KaiPeng21/VirtualSport/README.md

# VirtualSport
ECE477 Digital System Design Project
