KaiPeng21/VirtualSport/ECE477-SeniorDesignProject/Software/Microprocessor/MDK-ARM/Final-Version-1/Final-Version-1.htm

# Static Call Graph for image Final-Version-1\Final-Version-1.axf

#<CALLGRAPH># ARM Linker, 5060528: Last Updated: Mon Oct 30 10:10:53 2017

### Maximum Stack Usage = 152 bytes + Unknown(Cycles, Untraceable Function Pointers)

### Call chain for Maximum Stack Depth:

main ⇒ SystemClock_Config ⇒ HAL_RCC_ClockConfig ⇒ HAL_InitTick ⇒ HAL_NVIC_SetPriority

### Mutually Recursive functions

- ADC_IRQHandler ⇒ ADC_IRQHandler
- BusFault_Handler ⇒ BusFault_Handler
- HardFault_Handler ⇒ HardFault_Handler
- MemManage_Handler ⇒ MemManage_Handler
- UsageFault_Handler ⇒ UsageFault_Handler

### Function Pointers

- ADC_IRQHandler from startup_stm32f407xx.o(.text) referenced from startup_stm32f407xx.o(RESET)
- BusFault_Handler from stm32f4xx_it.o(i.BusFault_Handler) referenced from startup_stm32f407xx.o(RESET)
- CAN1_RX0_IRQHandler from startup_stm32f407xx.o(.text) referenced from startup_stm32f407xx.o(RESET)
- CAN1_RX1_IRQHandler from startup_stm32f407xx.o(.text) referenced from startup_stm32f407xx.o(RESET)
- CAN1_SCE_IRQHandler from startup_stm32f407xx.o(.text) referenced from startup_stm32f407xx.o(RESET)
- CAN1_TX_IRQHandler from startup_stm32f407xx.o(.text) referenced from startup_stm32f407xx.o(RESET)
- CAN2_RX0_IRQHandler from startup_stm32f407xx.o(.text) referenced from startup_stm32f407xx.o(RESET)
- CAN2_RX1_IRQHandler from startup_stm32f407xx.o(.text) referenced from startup_stm32f407xx.o(RESET)
- CAN2_SCE_IRQHandler from startup_stm32f407xx.o(.text) referenced from startup_stm32f407xx.o(RESET)
- CAN2_TX_IRQHandler from startup_stm32f407xx.o(.text) referenced from startup_stm32f407xx.o(RESET)
- DCMI_IRQHandler from startup_stm32f407xx.o(.text) referenced from startup_stm32f407xx.o(RESET)
- DMA1_Stream0_IRQHandler from startup_stm32f407xx.o(.text) referenced from startup_stm32f407xx.o(RESET)
- DMA1_Stream1_IRQHandler from startup_stm32f407xx.o(.text) referenced from startup_stm32f407xx.o(RESET)
- DMA1_Stream2_IRQHandler from startup_stm32f407xx.o(.text) referenced from startup_stm32f407xx.o(RESET)
- DMA1_Stream3_IRQHandler from startup_stm32f407xx.o(.text) referenced from startup_stm32f407xx.o(RESET)
- DMA1_Stream4_IRQHandler from startup_stm32f407xx.o(.text) referenced from startup_stm32f407xx.o(RESET)
- DMA1_Stream5_IRQHandler from startup_stm32f407xx.o(.text) referenced from startup_stm32f407xx.o(RESET)
- DMA1_Stream6_IRQHandler from startup_stm32f407xx.o(.text) referenced from startup_stm32f407xx.o(RESET)
- DMA1_Stream7_IRQHandler from startup_stm32f407xx.o(.text) referenced from startup_stm32f407xx.o(RESET)
- DMA2_Stream0_IRQHandler from startup_stm32f407xx.o(.text) referenced from startup_stm32f407xx.o(RESET)
- DMA2_Stream1_IRQHandler from startup_stm32f407xx.o(.text) referenced from startup_stm32f407xx.o(RESET)
- DMA2_Stream2_IRQHandler from startup_stm32f407xx.o(.text) referenced from startup_stm32f407xx.o(RESET)
- DMA2_Stream3_IRQHandler from startup_stm32f407xx.o(.text) referenced from startup_stm32f407xx.o(RESET)
- DMA2_Stream4_IRQHandler from startup_stm32f407xx.o(.text) referenced from startup_stm32f407xx.o(RESET)
- DMA2_Stream5_IRQHandler from startup_stm32f407xx.o(.text) referenced from startup_stm32f407xx.o(RESET)
- DMA2_Stream6_IRQHandler from startup_stm32f407xx.o(.text) referenced from startup_stm32f407xx.o(RESET)
- DMA2_Stream7_IRQHandler from startup_stm32f407xx.o(.text) referenced from startup_stm32f407xx.o(RESET)
- DebugMon_Handler from stm32f4xx_it.o(i.DebugMon_Handler) referenced from startup_stm32f407xx.o(RESET)
- ETH_IRQHandler from startup_stm32f407xx.o(.text) referenced from startup_stm32f407xx.o(RESET)
- ETH_WKUP_IRQHandler from startup_stm32f407xx.o(.text) referenced from startup_stm32f407xx.o(RESET)
- EXTI0_IRQHandler from startup_stm32f407xx.o(.text) referenced from startup_stm32f407xx.o(RESET)
- EXTI15_10_IRQHandler from startup_stm32f407xx.o(.text) referenced from startup_stm32f407xx.o(RESET)
- EXTI1_IRQHandler from startup_stm32f407xx.o(.text) referenced from startup_stm32f407xx.o(RESET)
- EXTI2_IRQHandler from startup_stm32f407xx.o(.text) referenced from startup_stm32f407xx.o(RESET)
- EXTI3_IRQHandler from startup_stm32f407xx.o(.text) referenced from startup_stm32f407xx.o(RESET)
- EXTI4_IRQHandler from startup_stm32f407xx.o(.text) referenced from startup_stm32f407xx.o(RESET)
- EXTI9_5_IRQHandler from startup_stm32f407xx.o(.text) referenced from startup_stm32f407xx.o(RESET)
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
- TIM7_IRQHandler from startup_stm32f407xx.o(.text) referenced from startup_stm32f407xx.o(RESET)
- TIM8_BRK_TIM12_IRQHandler from startup_stm32f407xx.o(.text) referenced from startup_stm32f407xx.o(RESET)
- TIM8_CC_IRQHandler from startup_stm32f407xx.o(.text) referenced from startup_stm32f407xx.o(RESET)
- TIM8_TRG_COM_TIM14_IRQHandler from startup_stm32f407xx.o(.text) referenced from startup_stm32f407xx.o(RESET)
- TIM8_UP_TIM13_IRQHandler from startup_stm32f407xx.o(.text) referenced from startup_stm32f407xx.o(RESET)
- UART4_IRQHandler from startup_stm32f407xx.o(.text) referenced from startup_stm32f407xx.o(RESET)
- UART5_IRQHandler from startup_stm32f407xx.o(.text) referenced from startup_stm32f407xx.o(RESET)
- UART_DMAAbortOnError from stm32f4xx_hal_uart.o(i.UART_DMAAbortOnError) referenced from stm32f4xx_hal_uart.o(i.HAL_UART_IRQHandler)
- USART1_IRQHandler from stm32f4xx_it.o(i.USART1_IRQHandler) referenced from startup_stm32f407xx.o(RESET)
- USART2_IRQHandler from startup_stm32f407xx.o(.text) referenced from startup_stm32f407xx.o(RESET)
- USART3_IRQHandler from startup_stm32f407xx.o(.text) referenced from startup_stm32f407xx.o(RESET)
- USART6_IRQHandler from startup_stm32f407xx.o(.text) referenced from startup_stm32f407xx.o(RESET)
- UsageFault_Handler from stm32f4xx_it.o(i.UsageFault_Handler) referenced from startup_stm32f407xx.o(RESET)
- WWDG_IRQHandler from startup_stm32f407xx.o(.text) referenced from startup_stm32f407xx.o(RESET)
- __main from entry.o(.ARM.Collect$$$$00000000) referenced from startup_stm32f407xx.o(.text)
- main from main.o(i.main) referenced from entry9a.o(.ARM.Collect$$$$0000000B)

### Global Symbols

__main (Thumb, 0 bytes, Stack size unknown bytes, entry.o(.ARM.Collect$$$$00000000))
[Address Reference Count : 1]

- startup_stm32f407xx.o(.text)

_main_stk (Thumb, 0 bytes, Stack size unknown bytes, entry2.o(.ARM.Collect$$$$00000001))

_main_scatterload (Thumb, 0 bytes, Stack size unknown bytes, entry5.o(.ARM.Collect$$$$00000004))

[Calls]

- >> __scatterload

__main_after_scatterload (Thumb, 0 bytes, Stack size unknown bytes, entry5.o(.ARM.Collect$$$$00000004))

[Called By]

- >> __scatterload

_main_clock (Thumb, 0 bytes, Stack size unknown bytes, entry7b.o(.ARM.Collect$$$$00000008))

_main_cpp_init (Thumb, 0 bytes, Stack size unknown bytes, entry8b.o(.ARM.Collect$$$$0000000A))

_main_init (Thumb, 0 bytes, Stack size unknown bytes, entry9a.o(.ARM.Collect$$$$0000000B))

__rt_final_cpp (Thumb, 0 bytes, Stack size unknown bytes, entry10a.o(.ARM.Collect$$$$0000000D))

__rt_final_exit (Thumb, 0 bytes, Stack size unknown bytes, entry11a.o(.ARM.Collect$$$$0000000F))

Reset_Handler (Thumb, 8 bytes, Stack size 0 bytes, startup_stm32f407xx.o(.text))
[Address Reference Count : 1]

- startup_stm32f407xx.o(RESET)

ADC_IRQHandler (Thumb, 0 bytes, Stack size 0 bytes, startup_stm32f407xx.o(.text))

[Calls]

- >> ADC_IRQHandler

[Called By]

- >> ADC_IRQHandler

[Address Reference Count : 1]

- startup_stm32f407xx.o(RESET)

CAN1_RX0_IRQHandler (Thumb, 0 bytes, Stack size 0 bytes, startup_stm32f407xx.o(.text))
[Address Reference Count : 1]

- startup_stm32f407xx.o(RESET)

CAN1_RX1_IRQHandler (Thumb, 0 bytes, Stack size 0 bytes, startup_stm32f407xx.o(.text))
[Address Reference Count : 1]

- startup_stm32f407xx.o(RESET)

CAN1_SCE_IRQHandler (Thumb, 0 bytes, Stack size 0 bytes, startup_stm32f407xx.o(.text))
[Address Reference Count : 1]

- startup_stm32f407xx.o(RESET)

CAN1_TX_IRQHandler (Thumb, 0 bytes, Stack size 0 bytes, startup_stm32f407xx.o(.text))
[Address Reference Count : 1]

- startup_stm32f407xx.o(RESET)

CAN2_RX0_IRQHandler (Thumb, 0 bytes, Stack size 0 bytes, startup_stm32f407xx.o(.text))
[Address Reference Count : 1]

- startup_stm32f407xx.o(RESET)

CAN2_RX1_IRQHandler (Thumb, 0 bytes, Stack size 0 bytes, startup_stm32f407xx.o(.text))
[Address Reference Count : 1]

- startup_stm32f407xx.o(RESET)

CAN2_SCE_IRQHandler (Thumb, 0 bytes, Stack size 0 bytes, startup_stm32f407xx.o(.text))
[Address Reference Count : 1]

- startup_stm32f407xx.o(RESET)

CAN2_TX_IRQHandler (Thumb, 0 bytes, Stack size 0 bytes, startup_stm32f407xx.o(.text))
[Address Reference Count : 1]

- startup_stm32f407xx.o(RESET)

DCMI_IRQHandler (Thumb, 0 bytes, Stack size 0 bytes, startup_stm32f407xx.o(.text))
[Address Reference Count : 1]

- startup_stm32f407xx.o(RESET)

DMA1_Stream0_IRQHandler (Thumb, 0 bytes, Stack size 0 bytes, startup_stm32f407xx.o(.text))
[Address Reference Count : 1]

- startup_stm32f407xx.o(RESET)

DMA1_Stream1_IRQHandler (Thumb, 0 bytes, Stack size 0 bytes, startup_stm32f407xx.o(.text))
[Address Reference Count : 1]

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
[Address Reference Count : 1]

- startup_stm32f407xx.o(RESET)

TIM1_BRK_TIM9_IRQHandler (Thumb, 0 bytes, Stack size 0 bytes, startup_stm32f407xx.o(.text))
[Address Reference Count : 1]

- startup_stm32f407xx.o(RESET)

TIM1_CC_IRQHandler (Thumb, 0 bytes, Stack size 0 bytes, startup_stm32f407xx.o(.text))
[Address Reference Count : 1]

- startup_stm32f407xx.o(RESET)

TIM1_TRG_COM_TIM11_IRQHandler (Thumb, 0 bytes, Stack size 0 bytes, startup_stm32f407xx.o(.text))
[Address Reference Count : 1]

- startup_stm32f407xx.o(RESET)

TIM1_UP_TIM10_IRQHandler (Thumb, 0 bytes, Stack size 0 bytes, startup_stm32f407xx.o(.text))
[Address Reference Count : 1]

- startup_stm32f407xx.o(RESET)

TIM2_IRQHandler (Thumb, 0 bytes, Stack size 0 bytes, startup_stm32f407xx.o(.text))
[Address Reference Count : 1]

- startup_stm32f407xx.o(RESET)

TIM5_IRQHandler (Thumb, 0 bytes, Stack size 0 bytes, startup_stm32f407xx.o(.text))
[Address Reference Count : 1]

- startup_stm32f407xx.o(RESET)

TIM7_IRQHandler (Thumb, 0 bytes, Stack size 0 bytes, startup_stm32f407xx.o(.text))
[Address Reference Count : 1]

- startup_stm32f407xx.o(RESET)

TIM8_BRK_TIM12_IRQHandler (Thumb, 0 bytes, Stack size 0 bytes, startup_stm32f407xx.o(.text))
[Address Reference Count : 1]

- startup_stm32f407xx.o(RESET)

TIM8_CC_IRQHandler (Thumb, 0 bytes, Stack size 0 bytes, startup_stm32f407xx.o(.text))
[Address Reference Count : 1]

- startup_stm32f407xx.o(RESET)

TIM8_TRG_COM_TIM14_IRQHandler (Thumb, 0 bytes, Stack size 0 bytes, startup_stm32f407xx.o(.text))
[Address Reference Count : 1]

- startup_stm32f407xx.o(RESET)

TIM8_UP_TIM13_IRQHandler (Thumb, 0 bytes, Stack size 0 bytes, startup_stm32f407xx.o(.text))
[Address Reference Count : 1]

- startup_stm32f407xx.o(RESET)

UART4_IRQHandler (Thumb, 0 bytes, Stack size 0 bytes, startup_stm32f407xx.o(.text))
[Address Reference Count : 1]

- startup_stm32f407xx.o(RESET)

UART5_IRQHandler (Thumb, 0 bytes, Stack size 0 bytes, startup_stm32f407xx.o(.text))
[Address Reference Count : 1]

- startup_stm32f407xx.o(RESET)

USART2_IRQHandler (Thumb, 0 bytes, Stack size 0 bytes, startup_stm32f407xx.o(.text))
[Address Reference Count : 1]

- startup_stm32f407xx.o(RESET)

USART3_IRQHandler (Thumb, 0 bytes, Stack size 0 bytes, startup_stm32f407xx.o(.text))
[Address Reference Count : 1]

- startup_stm32f407xx.o(RESET)

USART6_IRQHandler (Thumb, 0 bytes, Stack size 0 bytes, startup_stm32f407xx.o(.text))
[Address Reference Count : 1]

- startup_stm32f407xx.o(RESET)

WWDG_IRQHandler (Thumb, 0 bytes, Stack size 0 bytes, startup_stm32f407xx.o(.text))
[Address Reference Count : 1]

- startup_stm32f407xx.o(RESET)

__scatterload (Thumb, 28 bytes, Stack size 0 bytes, init.o(.text))

[Calls]

- >> __main_after_scatterload

[Called By]

- >> _main_scatterload

__scatterload_rt2 (Thumb, 0 bytes, Stack size 0 bytes, init.o(.text), UNUSED)

Bluetooth_Pack_and_Send (Thumb, 216 bytes, Stack size 16 bytes, main.o(i.Bluetooth_Pack_and_Send))

[Stack]

- Max Depth = 72
- Call Chain = Bluetooth_Pack_and_Send ⇒ HAL_UART_Transmit ⇒ UART_WaitOnFlagUntilTimeout

[Calls]

- >> HAL_UART_Transmit

[Called By]

- >> main

BusFault_Handler (Thumb, 2 bytes, Stack size 0 bytes, stm32f4xx_it.o(i.BusFault_Handler))

[Calls]

- >> BusFault_Handler

[Called By]

- >> BusFault_Handler

[Address Reference Count : 1]

- startup_stm32f407xx.o(RESET)

DRV_Go (Thumb, 36 bytes, Stack size 8 bytes, main.o(i.DRV_Go))

[Stack]

- Max Depth = 104
- Call Chain = DRV_Go ⇒ HAL_I2C_Master_Transmit ⇒ I2C_MasterRequestWrite ⇒ I2C_WaitOnMasterAddressFlagUntilTimeout

[Calls]

- >> HAL_I2C_Master_Transmit

[Called By]

- >> Haptics_VibrateMid
- >> Haptics_VibrateLow
- >> Haptics_VibrateHigh

DRV_SetWaveform (Thumb, 36 bytes, Stack size 16 bytes, main.o(i.DRV_SetWaveform))

[Stack]

- Max Depth = 112
- Call Chain = DRV_SetWaveform ⇒ HAL_I2C_Master_Transmit ⇒ I2C_MasterRequestWrite ⇒ I2C_WaitOnMasterAddressFlagUntilTimeout

[Calls]

- >> HAL_I2C_Master_Transmit

[Called By]

- >> Haptics_VibrateMid
- >> Haptics_VibrateLow
- >> Haptics_VibrateHigh

DebugMon_Handler (Thumb, 2 bytes, Stack size 0 bytes, stm32f4xx_it.o(i.DebugMon_Handler))
[Address Reference Count : 1]

- startup_stm32f407xx.o(RESET)

HAL_DMA_Abort_IT (Thumb, 36 bytes, Stack size 0 bytes, stm32f4xx_hal_dma.o(i.HAL_DMA_Abort_IT))

[Called By]

- >> HAL_UART_IRQHandler

HAL_Delay (Thumb, 28 bytes, Stack size 16 bytes, stm32f4xx_hal.o(i.HAL_Delay))

[Stack]

- Max Depth = 16
- Call Chain = HAL_Delay

[Calls]

- >> HAL_GetTick

[Called By]

- >> main

HAL_GPIO_Init (Thumb, 388 bytes, Stack size 40 bytes, stm32f4xx_hal_gpio.o(i.HAL_GPIO_Init))

[Stack]

- Max Depth = 40
- Call Chain = HAL_GPIO_Init

[Called By]

- >> HAL_UART_MspInit
- >> HAL_I2C_MspInit
- >> HAL_TIM_MspPostInit
- >> MX_GPIO_Init

HAL_GPIO_ReadPin (Thumb, 10 bytes, Stack size 0 bytes, stm32f4xx_hal_gpio.o(i.HAL_GPIO_ReadPin))

[Called By]

- >> main

HAL_GetTick (Thumb, 6 bytes, Stack size 0 bytes, stm32f4xx_hal.o(i.HAL_GetTick))

[Called By]

- >> HAL_UART_Transmit
- >> HAL_UART_Receive
- >> HAL_RCC_OscConfig
- >> HAL_RCC_ClockConfig
- >> HAL_I2C_Master_Transmit
- >> HAL_I2C_Master_Receive
- >> HAL_Delay
- >> I2C_WaitOnTXEFlagUntilTimeout
- >> I2C_WaitOnRXNEFlagUntilTimeout
- >> I2C_WaitOnMasterAddressFlagUntilTimeout
- >> I2C_WaitOnFlagUntilTimeout
- >> I2C_WaitOnBTFFlagUntilTimeout
- >> UART_WaitOnFlagUntilTimeout

HAL_I2C_Init (Thumb, 254 bytes, Stack size 16 bytes, stm32f4xx_hal_i2c.o(i.HAL_I2C_Init))

[Stack]

- Max Depth = 104
- Call Chain = HAL_I2C_Init ⇒ HAL_I2C_MspInit ⇒ HAL_GPIO_Init

[Calls]

- >> HAL_I2C_MspInit
- >> HAL_RCC_GetPCLK1Freq

[Called By]

- >> MX_I2C2_Init
- >> MX_I2C1_Init

HAL_I2C_Master_Receive (Thumb, 474 bytes, Stack size 40 bytes, stm32f4xx_hal_i2c.o(i.HAL_I2C_Master_Receive))

[Stack]

- Max Depth = 112
- Call Chain = HAL_I2C_Master_Receive ⇒ I2C_MasterRequestRead ⇒ I2C_WaitOnMasterAddressFlagUntilTimeout

[Calls]

- >> HAL_GetTick
- >> I2C_WaitOnRXNEFlagUntilTimeout
- >> I2C_WaitOnFlagUntilTimeout
- >> I2C_MasterRequestRead

[Called By]

- >> main

HAL_I2C_Master_Transmit (Thumb, 304 bytes, Stack size 40 bytes, stm32f4xx_hal_i2c.o(i.HAL_I2C_Master_Transmit))

[Stack]

- Max Depth = 96
- Call Chain = HAL_I2C_Master_Transmit ⇒ I2C_MasterRequestWrite ⇒ I2C_WaitOnMasterAddressFlagUntilTimeout

[Calls]

- >> HAL_GetTick
- >> I2C_WaitOnTXEFlagUntilTimeout
- >> I2C_WaitOnFlagUntilTimeout
- >> I2C_WaitOnBTFFlagUntilTimeout
- >> I2C_MasterRequestWrite

[Called By]

- >> main
- >> DRV_SetWaveform
- >> DRV_Go

HAL_I2C_MspInit (Thumb, 92 bytes, Stack size 48 bytes, stm32f4xx_hal_msp.o(i.HAL_I2C_MspInit))

[Stack]

- Max Depth = 88
- Call Chain = HAL_I2C_MspInit ⇒ HAL_GPIO_Init

[Calls]

- >> HAL_GPIO_Init

[Called By]

- >> HAL_I2C_Init

HAL_IncTick (Thumb, 10 bytes, Stack size 0 bytes, stm32f4xx_hal.o(i.HAL_IncTick))

[Called By]

- >> SysTick_Handler

HAL_Init (Thumb, 48 bytes, Stack size 8 bytes, stm32f4xx_hal.o(i.HAL_Init))

[Stack]

- Max Depth = 32
- Call Chain = HAL_Init ⇒ HAL_MspInit ⇒ HAL_NVIC_SetPriority

[Calls]

- >> HAL_NVIC_SetPriorityGrouping
- >> HAL_MspInit
- >> HAL_InitTick

[Called By]

- >> main

HAL_InitTick (Thumb, 34 bytes, Stack size 8 bytes, stm32f4xx_hal.o(i.HAL_InitTick))

[Stack]

- Max Depth = 24
- Call Chain = HAL_InitTick ⇒ HAL_NVIC_SetPriority

[Calls]

- >> HAL_SYSTICK_Config
- >> HAL_NVIC_SetPriority

[Called By]

- >> HAL_RCC_ClockConfig
- >> HAL_Init

HAL_MspInit (Thumb, 88 bytes, Stack size 8 bytes, stm32f4xx_hal_msp.o(i.HAL_MspInit))

[Stack]

- Max Depth = 24
- Call Chain = HAL_MspInit ⇒ HAL_NVIC_SetPriority

[Calls]

- >> HAL_NVIC_SetPriorityGrouping
- >> HAL_NVIC_SetPriority

[Called By]

- >> HAL_Init

HAL_NVIC_EnableIRQ (Thumb, 22 bytes, Stack size 0 bytes, stm32f4xx_hal_cortex.o(i.HAL_NVIC_EnableIRQ))

[Called By]

- >> HAL_UART_MspInit
- >> HAL_TIM_PWM_MspInit
- >> HAL_TIM_Base_MspInit

HAL_NVIC_SetPriority (Thumb, 60 bytes, Stack size 16 bytes, stm32f4xx_hal_cortex.o(i.HAL_NVIC_SetPriority))

[Stack]

- Max Depth = 16
- Call Chain = HAL_NVIC_SetPriority

[Calls]

- >> NVIC_SetPriority

[Called By]

- >> HAL_UART_MspInit
- >> HAL_TIM_PWM_MspInit
- >> HAL_TIM_Base_MspInit
- >> HAL_MspInit
- >> SystemClock_Config
- >> HAL_InitTick

HAL_NVIC_SetPriorityGrouping (Thumb, 26 bytes, Stack size 0 bytes, stm32f4xx_hal_cortex.o(i.HAL_NVIC_SetPriorityGrouping))

[Called By]

- >> HAL_MspInit
- >> HAL_Init

HAL_RCC_ClockConfig (Thumb, 364 bytes, Stack size 32 bytes, stm32f4xx_hal_rcc.o(i.HAL_RCC_ClockConfig))

[Stack]

- Max Depth = 56
- Call Chain = HAL_RCC_ClockConfig ⇒ HAL_InitTick ⇒ HAL_NVIC_SetPriority

[Calls]

- >> HAL_InitTick
- >> HAL_GetTick
- >> HAL_RCC_GetSysClockFreq

[Called By]

- >> SystemClock_Config

HAL_RCC_GetHCLKFreq (Thumb, 6 bytes, Stack size 0 bytes, stm32f4xx_hal_rcc.o(i.HAL_RCC_GetHCLKFreq))

[Called By]

- >> SystemClock_Config

HAL_RCC_GetPCLK1Freq (Thumb, 34 bytes, Stack size 0 bytes, stm32f4xx_hal_rcc.o(i.HAL_RCC_GetPCLK1Freq))

[Called By]

- >> HAL_I2C_Init
- >> UART_SetConfig

HAL_RCC_GetPCLK2Freq (Thumb, 34 bytes, Stack size 0 bytes, stm32f4xx_hal_rcc.o(i.HAL_RCC_GetPCLK2Freq))

[Called By]

- >> UART_SetConfig

HAL_RCC_GetSysClockFreq (Thumb, 104 bytes, Stack size 12 bytes, stm32f4xx_hal_rcc.o(i.HAL_RCC_GetSysClockFreq))

[Stack]

- Max Depth = 12
- Call Chain = HAL_RCC_GetSysClockFreq

[Called By]

- >> HAL_RCC_ClockConfig

HAL_RCC_OscConfig (Thumb, 770 bytes, Stack size 40 bytes, stm32f4xx_hal_rcc.o(i.HAL_RCC_OscConfig))

[Stack]

- Max Depth = 40
- Call Chain = HAL_RCC_OscConfig

[Calls]

- >> HAL_GetTick

[Called By]

- >> SystemClock_Config

HAL_SYSTICK_CLKSourceConfig (Thumb, 24 bytes, Stack size 0 bytes, stm32f4xx_hal_cortex.o(i.HAL_SYSTICK_CLKSourceConfig))

[Called By]

- >> SystemClock_Config

HAL_SYSTICK_Callback (Thumb, 2 bytes, Stack size 0 bytes, stm32f4xx_hal_cortex.o(i.HAL_SYSTICK_Callback))

[Called By]

- >> HAL_SYSTICK_IRQHandler

HAL_SYSTICK_Config (Thumb, 40 bytes, Stack size 8 bytes, stm32f4xx_hal_cortex.o(i.HAL_SYSTICK_Config))

[Stack]

- Max Depth = 8
- Call Chain = HAL_SYSTICK_Config

[Calls]

- >> NVIC_SetPriority

[Called By]

- >> SystemClock_Config
- >> HAL_InitTick

HAL_SYSTICK_IRQHandler (Thumb, 8 bytes, Stack size 8 bytes, stm32f4xx_hal_cortex.o(i.HAL_SYSTICK_IRQHandler))

[Stack]

- Max Depth = 8
- Call Chain = HAL_SYSTICK_IRQHandler

[Calls]

- >> HAL_SYSTICK_Callback

[Called By]

- >> SysTick_Handler

HAL_TIMEx_BreakCallback (Thumb, 2 bytes, Stack size 0 bytes, stm32f4xx_hal_tim_ex.o(i.HAL_TIMEx_BreakCallback))

[Called By]

- >> HAL_TIM_IRQHandler

HAL_TIMEx_CommutationCallback (Thumb, 2 bytes, Stack size 0 bytes, stm32f4xx_hal_tim_ex.o(i.HAL_TIMEx_CommutationCallback))

[Called By]

- >> HAL_TIM_IRQHandler

HAL_TIMEx_MasterConfigSynchronization (Thumb, 80 bytes, Stack size 12 bytes, stm32f4xx_hal_tim_ex.o(i.HAL_TIMEx_MasterConfigSynchronization))

[Stack]

- Max Depth = 12
- Call Chain = HAL_TIMEx_MasterConfigSynchronization

[Called By]

- >> main
- >> MX_TIM4_Init
- >> MX_TIM3_Init

HAL_TIM_Base_Init (Thumb, 54 bytes, Stack size 8 bytes, stm32f4xx_hal_tim.o(i.HAL_TIM_Base_Init))

[Stack]

- Max Depth = 32
- Call Chain = HAL_TIM_Base_Init ⇒ HAL_TIM_Base_MspInit ⇒ HAL_NVIC_SetPriority

[Calls]

- >> HAL_TIM_Base_MspInit
- >> TIM_Base_SetConfig

[Called By]

- >> main

HAL_TIM_Base_MspInit (Thumb, 50 bytes, Stack size 8 bytes, stm32f4xx_hal_msp.o(i.HAL_TIM_Base_MspInit))

[Stack]

- Max Depth = 24
- Call Chain = HAL_TIM_Base_MspInit ⇒ HAL_NVIC_SetPriority

[Calls]

- >> HAL_NVIC_EnableIRQ
- >> HAL_NVIC_SetPriority

[Called By]

- >> HAL_TIM_Base_Init

HAL_TIM_Base_Start_IT (Thumb, 24 bytes, Stack size 0 bytes, stm32f4xx_hal_tim.o(i.HAL_TIM_Base_Start_IT))

[Called By]

- >> main

HAL_TIM_IC_CaptureCallback (Thumb, 2 bytes, Stack size 0 bytes, stm32f4xx_hal_tim.o(i.HAL_TIM_IC_CaptureCallback))

[Called By]

- >> HAL_TIM_IRQHandler

HAL_TIM_IRQHandler (Thumb, 358 bytes, Stack size 16 bytes, stm32f4xx_hal_tim.o(i.HAL_TIM_IRQHandler))

[Stack]

- Max Depth = 16
- Call Chain = HAL_TIM_IRQHandler

[Calls]

- >> HAL_TIM_PeriodElapsedCallback
- >> HAL_TIM_TriggerCallback
- >> HAL_TIM_PWM_PulseFinishedCallback
- >> HAL_TIM_OC_DelayElapsedCallback
- >> HAL_TIM_IC_CaptureCallback
- >> HAL_TIMEx_CommutationCallback
- >> HAL_TIMEx_BreakCallback

[Called By]

- >> TIM6_DAC_IRQHandler
- >> TIM4_IRQHandler
- >> TIM3_IRQHandler

HAL_TIM_MspPostInit (Thumb, 68 bytes, Stack size 24 bytes, stm32f4xx_hal_msp.o(i.HAL_TIM_MspPostInit))

[Stack]

- Max Depth = 64
- Call Chain = HAL_TIM_MspPostInit ⇒ HAL_GPIO_Init

[Calls]

- >> HAL_GPIO_Init

[Called By]

- >> MX_TIM4_Init
- >> MX_TIM3_Init

HAL_TIM_OC_DelayElapsedCallback (Thumb, 2 bytes, Stack size 0 bytes, stm32f4xx_hal_tim.o(i.HAL_TIM_OC_DelayElapsedCallback))

[Called By]

- >> HAL_TIM_IRQHandler

HAL_TIM_PWM_ConfigChannel (Thumb, 208 bytes, Stack size 16 bytes, stm32f4xx_hal_tim.o(i.HAL_TIM_PWM_ConfigChannel))

[Stack]

- Max Depth = 28
- Call Chain = HAL_TIM_PWM_ConfigChannel ⇒ TIM_OC4_SetConfig

[Calls]

- >> TIM_OC4_SetConfig
- >> TIM_OC3_SetConfig
- >> TIM_OC1_SetConfig
- >> TIM_OC2_SetConfig

[Called By]

- >> MX_TIM4_Init
- >> MX_TIM3_Init

HAL_TIM_PWM_Init (Thumb, 54 bytes, Stack size 8 bytes, stm32f4xx_hal_tim.o(i.HAL_TIM_PWM_Init))

[Stack]

- Max Depth = 32
- Call Chain = HAL_TIM_PWM_Init ⇒ HAL_TIM_PWM_MspInit ⇒ HAL_NVIC_SetPriority

[Calls]

- >> HAL_TIM_PWM_MspInit
- >> TIM_Base_SetConfig

[Called By]

- >> MX_TIM4_Init
- >> MX_TIM3_Init

HAL_TIM_PWM_MspInit (Thumb, 86 bytes, Stack size 8 bytes, stm32f4xx_hal_msp.o(i.HAL_TIM_PWM_MspInit))

[Stack]

- Max Depth = 24
- Call Chain = HAL_TIM_PWM_MspInit ⇒ HAL_NVIC_SetPriority

[Calls]

- >> HAL_NVIC_EnableIRQ
- >> HAL_NVIC_SetPriority

[Called By]

- >> HAL_TIM_PWM_Init

HAL_TIM_PWM_PulseFinishedCallback (Thumb, 2 bytes, Stack size 0 bytes, stm32f4xx_hal_tim.o(i.HAL_TIM_PWM_PulseFinishedCallback))

[Called By]

- >> HAL_TIM_IRQHandler

HAL_TIM_PWM_Start (Thumb, 48 bytes, Stack size 8 bytes, stm32f4xx_hal_tim.o(i.HAL_TIM_PWM_Start))

[Stack]

- Max Depth = 16
- Call Chain = HAL_TIM_PWM_Start ⇒ TIM_CCxChannelCmd

[Calls]

- >> TIM_CCxChannelCmd

[Called By]

- >> main

HAL_TIM_PeriodElapsedCallback (Thumb, 64 bytes, Stack size 0 bytes, main.o(i.HAL_TIM_PeriodElapsedCallback))

[Called By]

- >> HAL_TIM_IRQHandler

HAL_TIM_TriggerCallback (Thumb, 2 bytes, Stack size 0 bytes, stm32f4xx_hal_tim.o(i.HAL_TIM_TriggerCallback))

[Called By]

- >> HAL_TIM_IRQHandler

HAL_UART_ErrorCallback (Thumb, 2 bytes, Stack size 0 bytes, stm32f4xx_hal_uart.o(i.HAL_UART_ErrorCallback))

[Called By]

- >> HAL_UART_IRQHandler
- >> UART_DMAAbortOnError

HAL_UART_IRQHandler (Thumb, 266 bytes, Stack size 16 bytes, stm32f4xx_hal_uart.o(i.HAL_UART_IRQHandler))

[Stack]

- Max Depth = 24
- Call Chain = HAL_UART_IRQHandler ⇒ UART_Receive_IT

[Calls]

- >> HAL_DMA_Abort_IT
- >> HAL_UART_TxCpltCallback
- >> HAL_UART_ErrorCallback
- >> UART_Transmit_IT
- >> UART_Receive_IT
- >> UART_EndRxTransfer

[Called By]

- >> USART1_IRQHandler

HAL_UART_Init (Thumb, 98 bytes, Stack size 16 bytes, stm32f4xx_hal_uart.o(i.HAL_UART_Init))

[Stack]

- Max Depth = 96
- Call Chain = HAL_UART_Init ⇒ HAL_UART_MspInit ⇒ HAL_GPIO_Init

[Calls]

- >> HAL_UART_MspInit
- >> UART_SetConfig

[Called By]

- >> main

HAL_UART_MspInit (Thumb, 114 bytes, Stack size 40 bytes, stm32f4xx_hal_msp.o(i.HAL_UART_MspInit))

[Stack]

- Max Depth = 80
- Call Chain = HAL_UART_MspInit ⇒ HAL_GPIO_Init

[Calls]

- >> HAL_NVIC_EnableIRQ
- >> HAL_NVIC_SetPriority
- >> HAL_GPIO_Init

[Called By]

- >> HAL_UART_Init

HAL_UART_Receive (Thumb, 184 bytes, Stack size 32 bytes, stm32f4xx_hal_uart.o(i.HAL_UART_Receive))

[Stack]

- Max Depth = 56
- Call Chain = HAL_UART_Receive ⇒ UART_WaitOnFlagUntilTimeout

[Calls]

- >> HAL_GetTick
- >> UART_WaitOnFlagUntilTimeout

[Called By]

- >> main

HAL_UART_RxCpltCallback (Thumb, 2 bytes, Stack size 0 bytes, stm32f4xx_hal_uart.o(i.HAL_UART_RxCpltCallback))

[Called By]

- >> UART_Receive_IT

HAL_UART_Transmit (Thumb, 186 bytes, Stack size 32 bytes, stm32f4xx_hal_uart.o(i.HAL_UART_Transmit))

[Stack]

- Max Depth = 56
- Call Chain = HAL_UART_Transmit ⇒ UART_WaitOnFlagUntilTimeout

[Calls]

- >> HAL_GetTick
- >> UART_WaitOnFlagUntilTimeout

[Called By]

- >> Bluetooth_Pack_and_Send

HAL_UART_TxCpltCallback (Thumb, 2 bytes, Stack size 0 bytes, stm32f4xx_hal_uart.o(i.HAL_UART_TxCpltCallback))

[Called By]

- >> HAL_UART_IRQHandler

Haptics_VibrateHigh (Thumb, 66 bytes, Stack size 8 bytes, main.o(i.Haptics_VibrateHigh))

[Stack]

- Max Depth = 120
- Call Chain = Haptics_VibrateHigh ⇒ DRV_SetWaveform ⇒ HAL_I2C_Master_Transmit ⇒ I2C_MasterRequestWrite ⇒ I2C_WaitOnMasterAddressFlagUntilTimeout

[Calls]

- >> DRV_SetWaveform
- >> DRV_Go

[Called By]

- >> main

Haptics_VibrateLow (Thumb, 68 bytes, Stack size 8 bytes, main.o(i.Haptics_VibrateLow))

[Stack]

- Max Depth = 120
- Call Chain = Haptics_VibrateLow ⇒ DRV_SetWaveform ⇒ HAL_I2C_Master_Transmit ⇒ I2C_MasterRequestWrite ⇒ I2C_WaitOnMasterAddressFlagUntilTimeout

[Calls]

- >> DRV_SetWaveform
- >> DRV_Go

[Called By]

- >> main

Haptics_VibrateMid (Thumb, 66 bytes, Stack size 8 bytes, main.o(i.Haptics_VibrateMid))

[Stack]

- Max Depth = 120
- Call Chain = Haptics_VibrateMid ⇒ DRV_SetWaveform ⇒ HAL_I2C_Master_Transmit ⇒ I2C_MasterRequestWrite ⇒ I2C_WaitOnMasterAddressFlagUntilTimeout

[Calls]

- >> DRV_SetWaveform
- >> DRV_Go

[Called By]

- >> main

HardFault_Handler (Thumb, 2 bytes, Stack size 0 bytes, stm32f4xx_it.o(i.HardFault_Handler))

[Calls]

- >> HardFault_Handler

[Called By]

- >> HardFault_Handler

[Address Reference Count : 1]

- startup_stm32f407xx.o(RESET)

MemManage_Handler (Thumb, 2 bytes, Stack size 0 bytes, stm32f4xx_it.o(i.MemManage_Handler))

[Calls]

- >> MemManage_Handler

[Called By]

- >> MemManage_Handler

[Address Reference Count : 1]

- startup_stm32f407xx.o(RESET)

NMI_Handler (Thumb, 2 bytes, Stack size 0 bytes, stm32f4xx_it.o(i.NMI_Handler))
[Address Reference Count : 1]

- startup_stm32f407xx.o(RESET)

PendSV_Handler (Thumb, 2 bytes, Stack size 0 bytes, stm32f4xx_it.o(i.PendSV_Handler))
[Address Reference Count : 1]

- startup_stm32f407xx.o(RESET)

SVC_Handler (Thumb, 2 bytes, Stack size 0 bytes, stm32f4xx_it.o(i.SVC_Handler))
[Address Reference Count : 1]

- startup_stm32f407xx.o(RESET)

ServoDown (Thumb, 14 bytes, Stack size 0 bytes, main.o(i.ServoDown))

[Called By]

- >> main

ServoUp (Thumb, 14 bytes, Stack size 0 bytes, main.o(i.ServoUp))

[Called By]

- >> main

SysTick_Handler (Thumb, 14 bytes, Stack size 8 bytes, stm32f4xx_it.o(i.SysTick_Handler))

[Stack]

- Max Depth = 16
- Call Chain = SysTick_Handler ⇒ HAL_SYSTICK_IRQHandler

[Calls]

- >> HAL_SYSTICK_IRQHandler
- >> HAL_IncTick

[Address Reference Count : 1]

- startup_stm32f407xx.o(RESET)

SystemClock_Config (Thumb, 126 bytes, Stack size 80 bytes, main.o(i.SystemClock_Config))

[Stack]

- Max Depth = 136
- Call Chain = SystemClock_Config ⇒ HAL_RCC_ClockConfig ⇒ HAL_InitTick ⇒ HAL_NVIC_SetPriority

[Calls]

- >> HAL_SYSTICK_Config
- >> HAL_SYSTICK_CLKSourceConfig
- >> HAL_RCC_OscConfig
- >> HAL_RCC_GetHCLKFreq
- >> HAL_RCC_ClockConfig
- >> HAL_NVIC_SetPriority

[Called By]

- >> main

SystemInit (Thumb, 66 bytes, Stack size 0 bytes, system_stm32f4xx.o(i.SystemInit))
[Address Reference Count : 1]

- startup_stm32f407xx.o(.text)

TIM3_IRQHandler (Thumb, 6 bytes, Stack size 0 bytes, stm32f4xx_it.o(i.TIM3_IRQHandler))

[Stack]

- Max Depth = 16
- Call Chain = TIM3_IRQHandler ⇒ HAL_TIM_IRQHandler

[Calls]

- >> HAL_TIM_IRQHandler

[Address Reference Count : 1]

- startup_stm32f407xx.o(RESET)

TIM4_IRQHandler (Thumb, 6 bytes, Stack size 0 bytes, stm32f4xx_it.o(i.TIM4_IRQHandler))

[Stack]

- Max Depth = 16
- Call Chain = TIM4_IRQHandler ⇒ HAL_TIM_IRQHandler

[Calls]

- >> HAL_TIM_IRQHandler

[Address Reference Count : 1]

- startup_stm32f407xx.o(RESET)

TIM6_DAC_IRQHandler (Thumb, 6 bytes, Stack size 0 bytes, stm32f4xx_it.o(i.TIM6_DAC_IRQHandler))

[Stack]

- Max Depth = 16
- Call Chain = TIM6_DAC_IRQHandler ⇒ HAL_TIM_IRQHandler

[Calls]

- >> HAL_TIM_IRQHandler

[Address Reference Count : 1]

- startup_stm32f407xx.o(RESET)

TIM_Base_SetConfig (Thumb, 148 bytes, Stack size 20 bytes, stm32f4xx_hal_tim.o(i.TIM_Base_SetConfig))

[Stack]

- Max Depth = 20
- Call Chain = TIM_Base_SetConfig

[Called By]

- >> HAL_TIM_PWM_Init
- >> HAL_TIM_Base_Init

TIM_CCxChannelCmd (Thumb, 22 bytes, Stack size 8 bytes, stm32f4xx_hal_tim.o(i.TIM_CCxChannelCmd))

[Stack]

- Max Depth = 8
- Call Chain = TIM_CCxChannelCmd

[Called By]

- >> HAL_TIM_PWM_Start

TIM_OC2_SetConfig (Thumb, 90 bytes, Stack size 12 bytes, stm32f4xx_hal_tim.o(i.TIM_OC2_SetConfig))

[Stack]

- Max Depth = 12
- Call Chain = TIM_OC2_SetConfig

[Called By]

- >> HAL_TIM_PWM_ConfigChannel

USART1_IRQHandler (Thumb, 6 bytes, Stack size 0 bytes, stm32f4xx_it.o(i.USART1_IRQHandler))

[Stack]

- Max Depth = 24
- Call Chain = USART1_IRQHandler ⇒ HAL_UART_IRQHandler ⇒ UART_Receive_IT

[Calls]

- >> HAL_UART_IRQHandler

[Address Reference Count : 1]

- startup_stm32f407xx.o(RESET)

UsageFault_Handler (Thumb, 2 bytes, Stack size 0 bytes, stm32f4xx_it.o(i.UsageFault_Handler))

[Calls]

- >> UsageFault_Handler

[Called By]

- >> UsageFault_Handler

[Address Reference Count : 1]

- startup_stm32f407xx.o(RESET)

__scatterload_copy (Thumb, 14 bytes, Stack size unknown bytes, handlers.o(i.__scatterload_copy), UNUSED)

__scatterload_null (Thumb, 2 bytes, Stack size unknown bytes, handlers.o(i.__scatterload_null), UNUSED)

__scatterload_zeroinit (Thumb, 14 bytes, Stack size unknown bytes, handlers.o(i.__scatterload_zeroinit), UNUSED)

main (Thumb, 716 bytes, Stack size 16 bytes, main.o(i.main))

[Stack]

- Max Depth = 152
- Call Chain = main ⇒ SystemClock_Config ⇒ HAL_RCC_ClockConfig ⇒ HAL_InitTick ⇒ HAL_NVIC_SetPriority

[Calls]

- >> HAL_UART_Receive
- >> HAL_UART_Init
- >> HAL_TIM_PWM_Start
- >> HAL_TIM_Base_Start_IT
- >> HAL_TIM_Base_Init
- >> HAL_TIMEx_MasterConfigSynchronization
- >> HAL_Init
- >> HAL_I2C_Master_Transmit
- >> HAL_I2C_Master_Receive
- >> HAL_GPIO_ReadPin
- >> HAL_Delay
- >> SystemClock_Config
- >> ServoUp
- >> ServoDown
- >> Haptics_VibrateMid
- >> Haptics_VibrateLow
- >> Haptics_VibrateHigh
- >> Bluetooth_Pack_and_Send
- >> MX_TIM4_Init
- >> MX_TIM3_Init
- >> MX_I2C2_Init
- >> MX_I2C1_Init
- >> MX_GPIO_Init

[Address Reference Count : 1]

- entry9a.o(.ARM.Collect$$$$0000000B)

### Local Symbols

MX_GPIO_Init (Thumb, 108 bytes, Stack size 32 bytes, main.o(i.MX_GPIO_Init))

[Stack]

- Max Depth = 72
- Call Chain = MX_GPIO_Init ⇒ HAL_GPIO_Init

[Calls]

- >> HAL_GPIO_Init

[Called By]

- >> main

MX_I2C1_Init (Thumb, 44 bytes, Stack size 8 bytes, main.o(i.MX_I2C1_Init))

[Stack]

- Max Depth = 112
- Call Chain = MX_I2C1_Init ⇒ HAL_I2C_Init ⇒ HAL_I2C_MspInit ⇒ HAL_GPIO_Init

[Calls]

- >> HAL_I2C_Init

[Called By]

- >> main

MX_I2C2_Init (Thumb, 44 bytes, Stack size 8 bytes, main.o(i.MX_I2C2_Init))

[Stack]

- Max Depth = 112
- Call Chain = MX_I2C2_Init ⇒ HAL_I2C_Init ⇒ HAL_I2C_MspInit ⇒ HAL_GPIO_Init

[Calls]

- >> HAL_I2C_Init

[Called By]

- >> main

MX_TIM3_Init (Thumb, 128 bytes, Stack size 48 bytes, main.o(i.MX_TIM3_Init))

[Stack]

- Max Depth = 112
- Call Chain = MX_TIM3_Init ⇒ HAL_TIM_MspPostInit ⇒ HAL_GPIO_Init

[Calls]

- >> HAL_TIM_PWM_Init
- >> HAL_TIM_PWM_ConfigChannel
- >> HAL_TIM_MspPostInit
- >> HAL_TIMEx_MasterConfigSynchronization

[Called By]

- >> main

MX_TIM4_Init (Thumb, 128 bytes, Stack size 48 bytes, main.o(i.MX_TIM4_Init))

[Stack]

- Max Depth = 112
- Call Chain = MX_TIM4_Init ⇒ HAL_TIM_MspPostInit ⇒ HAL_GPIO_Init

[Calls]

- >> HAL_TIM_PWM_Init
- >> HAL_TIM_PWM_ConfigChannel
- >> HAL_TIM_MspPostInit
- >> HAL_TIMEx_MasterConfigSynchronization

[Called By]

- >> main

NVIC_SetPriority (Thumb, 32 bytes, Stack size 0 bytes, stm32f4xx_hal_cortex.o(i.NVIC_SetPriority))

[Called By]

- >> HAL_SYSTICK_Config
- >> HAL_NVIC_SetPriority

TIM_OC1_SetConfig (Thumb, 80 bytes, Stack size 12 bytes, stm32f4xx_hal_tim.o(i.TIM_OC1_SetConfig))

[Stack]

- Max Depth = 12
- Call Chain = TIM_OC1_SetConfig

[Called By]

- >> HAL_TIM_PWM_ConfigChannel

TIM_OC3_SetConfig (Thumb, 88 bytes, Stack size 12 bytes, stm32f4xx_hal_tim.o(i.TIM_OC3_SetConfig))

[Stack]

- Max Depth = 12
- Call Chain = TIM_OC3_SetConfig

[Called By]

- >> HAL_TIM_PWM_ConfigChannel

TIM_OC4_SetConfig (Thumb, 70 bytes, Stack size 12 bytes, stm32f4xx_hal_tim.o(i.TIM_OC4_SetConfig))

[Stack]

- Max Depth = 12
- Call Chain = TIM_OC4_SetConfig

[Called By]

- >> HAL_TIM_PWM_ConfigChannel

UART_DMAAbortOnError (Thumb, 16 bytes, Stack size 8 bytes, stm32f4xx_hal_uart.o(i.UART_DMAAbortOnError))

[Stack]

- Max Depth = 8
- Call Chain = UART_DMAAbortOnError

[Calls]

- >> HAL_UART_ErrorCallback

[Address Reference Count : 1]

- stm32f4xx_hal_uart.o(i.HAL_UART_IRQHandler)

UART_EndRxTransfer (Thumb, 28 bytes, Stack size 0 bytes, stm32f4xx_hal_uart.o(i.UART_EndRxTransfer))

[Called By]

- >> HAL_UART_IRQHandler

UART_Receive_IT (Thumb, 140 bytes, Stack size 8 bytes, stm32f4xx_hal_uart.o(i.UART_Receive_IT))

[Stack]

- Max Depth = 8
- Call Chain = UART_Receive_IT

[Calls]

- >> HAL_UART_RxCpltCallback

[Called By]

- >> HAL_UART_IRQHandler

UART_SetConfig (Thumb, 676 bytes, Stack size 24 bytes, stm32f4xx_hal_uart.o(i.UART_SetConfig))

[Stack]

- Max Depth = 24
- Call Chain = UART_SetConfig

[Calls]

- >> HAL_RCC_GetPCLK2Freq
- >> HAL_RCC_GetPCLK1Freq

[Called By]

- >> HAL_UART_Init

UART_Transmit_IT (Thumb, 98 bytes, Stack size 0 bytes, stm32f4xx_hal_uart.o(i.UART_Transmit_IT))

[Called By]

- >> HAL_UART_IRQHandler

UART_WaitOnFlagUntilTimeout (Thumb, 100 bytes, Stack size 24 bytes, stm32f4xx_hal_uart.o(i.UART_WaitOnFlagUntilTimeout))

[Stack]

- Max Depth = 24
- Call Chain = UART_WaitOnFlagUntilTimeout

[Calls]

- >> HAL_GetTick

[Called By]

- >> HAL_UART_Transmit
- >> HAL_UART_Receive

I2C_IsAcknowledgeFailed (Thumb, 40 bytes, Stack size 0 bytes, stm32f4xx_hal_i2c.o(i.I2C_IsAcknowledgeFailed))

[Called By]

- >> I2C_WaitOnTXEFlagUntilTimeout
- >> I2C_WaitOnBTFFlagUntilTimeout

I2C_MasterRequestRead (Thumb, 222 bytes, Stack size 40 bytes, stm32f4xx_hal_i2c.o(i.I2C_MasterRequestRead))

[Stack]

- Max Depth = 72
- Call Chain = I2C_MasterRequestRead ⇒ I2C_WaitOnMasterAddressFlagUntilTimeout

[Calls]

- >> I2C_WaitOnMasterAddressFlagUntilTimeout
- >> I2C_WaitOnFlagUntilTimeout

[Called By]

- >> HAL_I2C_Master_Receive

I2C_MasterRequestWrite (Thumb, 142 bytes, Stack size 24 bytes, stm32f4xx_hal_i2c.o(i.I2C_MasterRequestWrite))

[Stack]

- Max Depth = 56
- Call Chain = I2C_MasterRequestWrite ⇒ I2C_WaitOnMasterAddressFlagUntilTimeout

[Calls]

- >> I2C_WaitOnMasterAddressFlagUntilTimeout
- >> I2C_WaitOnFlagUntilTimeout

[Called By]

- >> HAL_I2C_Master_Transmit

I2C_WaitOnBTFFlagUntilTimeout (Thumb, 78 bytes, Stack size 16 bytes, stm32f4xx_hal_i2c.o(i.I2C_WaitOnBTFFlagUntilTimeout))

[Stack]

- Max Depth = 16
- Call Chain = I2C_WaitOnBTFFlagUntilTimeout

[Calls]

- >> HAL_GetTick
- >> I2C_IsAcknowledgeFailed

[Called By]

- >> HAL_I2C_Master_Transmit

I2C_WaitOnFlagUntilTimeout (Thumb, 96 bytes, Stack size 32 bytes, stm32f4xx_hal_i2c.o(i.I2C_WaitOnFlagUntilTimeout))

[Stack]

- Max Depth = 32
- Call Chain = I2C_WaitOnFlagUntilTimeout

[Calls]

- >> HAL_GetTick

[Called By]

- >> HAL_I2C_Master_Transmit
- >> HAL_I2C_Master_Receive
- >> I2C_MasterRequestWrite
- >> I2C_MasterRequestRead

I2C_WaitOnMasterAddressFlagUntilTimeout (Thumb, 136 bytes, Stack size 32 bytes, stm32f4xx_hal_i2c.o(i.I2C_WaitOnMasterAddressFlagUntilTimeout))

[Stack]

- Max Depth = 32
- Call Chain = I2C_WaitOnMasterAddressFlagUntilTimeout

[Calls]

- >> HAL_GetTick

[Called By]

- >> I2C_MasterRequestWrite
- >> I2C_MasterRequestRead

I2C_WaitOnRXNEFlagUntilTimeout (Thumb, 98 bytes, Stack size 24 bytes, stm32f4xx_hal_i2c.o(i.I2C_WaitOnRXNEFlagUntilTimeout))

[Stack]

- Max Depth = 24
- Call Chain = I2C_WaitOnRXNEFlagUntilTimeout

[Calls]

- >> HAL_GetTick

[Called By]

- >> HAL_I2C_Master_Receive

I2C_WaitOnTXEFlagUntilTimeout (Thumb, 78 bytes, Stack size 16 bytes, stm32f4xx_hal_i2c.o(i.I2C_WaitOnTXEFlagUntilTimeout))

[Stack]

- Max Depth = 16
- Call Chain = I2C_WaitOnTXEFlagUntilTimeout

[Calls]

- >> HAL_GetTick
- >> I2C_IsAcknowledgeFailed

[Called By]

- >> HAL_I2C_Master_Transmit

### Undefined Global Symbols
