KaiPeng21/VirtualSport/ECE477-SeniorDesignProject/Document/team03-05-BillOfMaterial.xlsx

ECE477 Bill of Materials v1.0
Year: | 2017 | Semester: | Fall |  | Project Name: | Virtual Sport
Author: |  | Chia-Hua Peng | Lingke Yu | Hengyi Lin | Yutao Hu
Created: |  | 2017-09-10
Last Modified: |  | 2017-09-15
Project_Component |  |  |  |  |  |  |  | Qty:
Description | ID | Qty | Value | Package | Manufacturer | Mfg. Part # | Supplier | Supplier Part #
STM32 Microcontroller |  | 6 | NA | 100LQFP | STMicroelectronics | STM32F407VG | Digikey | 497-11605-ND
ADXL Accelerometer |  | 3 | NA | 14-terminal LGA | AnalogDevices | ADXL345 | Digikey | ADXL345TCCZ-EP-RL-ND
MPU Accelerometer + Gyro (Backup Plan) |  | 3 | NA | QFN | TDK invenSense | MPU6050 | Digikey | 1428-1007-2-ND
DRV Haptic Driver |  | 3 | NA | 10-pin VSSOP | Texas Instruments | DRV2605L | Digikey | 296-38481-2-ND
Bluetooth LE |  | 5 | NA | Standalone | JNHuaMao | HM10 | Amazon | NA
Vibration Motor |  | 10 | NA | Standalone | Jinlong Machinery and Electronics | Z3OC1T8219731 | Amazon | NA
Servo Motor (Backup Plan) |  | 5 | NA | Standalone | TowerPro | SG90 | Amazon | NA
Linear Servo Motor |  | 2 | NA | Standalone | Dong Yang Model Technology | GS-1502 | Amazon | NA
Resistor |  | 10 | 10KOhm | 0805 | TE Connectivity AMP Connectors | RES KIT 0805RS | Digikey | RES KIT 0805RS-ND
Capacitor |  | 10 | 0.1uF | 0805 | TE Connectivity AMP Connectors | S-0805DIGI | Digikey | 709-1111-ND
DC to DC Voltage Regulator |  | 3 | 7-36V to 5V, 90.5% efficiency | 3-SIP | Murata Power Solutions Inc. | OKI-78SR-5/1.5-W36H-C | Digikey | 811-2692-ND
Current LDO Regulator |  | 10 | Max 16 Vin to 3.3 Vout | TO-236-3, SC-59, SOT-23-3 | Microchip Technology | MCP1703T-3302E/CB | Digikey | MCP1703T-3302E/CBTR-ND
