KaiPeng21/VirtualSport/ECE477-SeniorDesignProject/Mechanical/package-grp1.stl

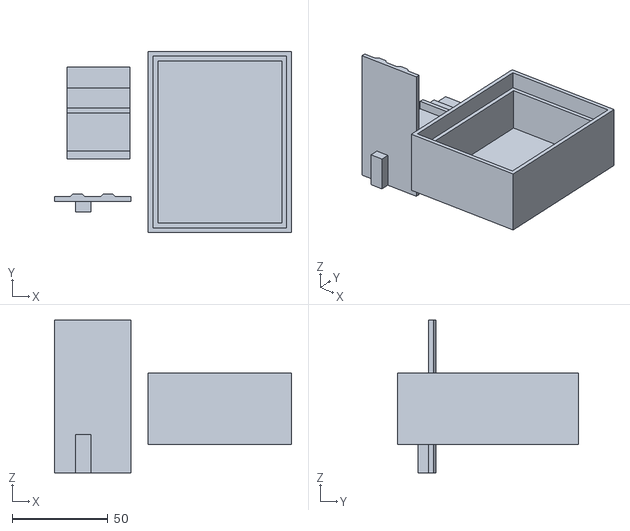
[picture p39: CAD file, 2017-12-07]
ECE477-SeniorDesignProject/Mechanical/package-grp1.stl
124.1 x 95.0 x 80.0
