KaiPeng21/VirtualSport/ECE477-SeniorDesignProject/Mechanical/package-grp3.stl

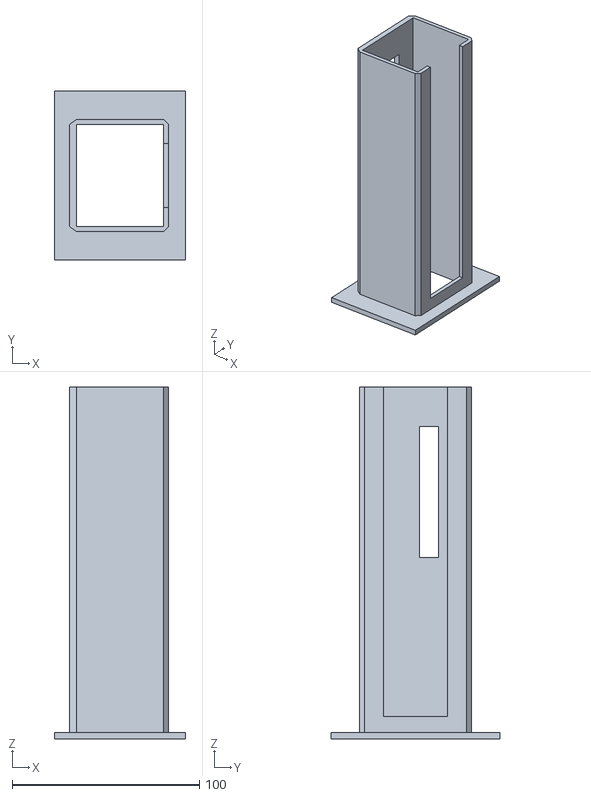
[picture p40: CAD file, 2017-12-07]
ECE477-SeniorDesignProject/Mechanical/package-grp3.stl
70.0 x 90.0 x 188.0
