KaiPeng21/VirtualSport/ECE477-SeniorDesignProject/Mechanical/linear-servo.stl

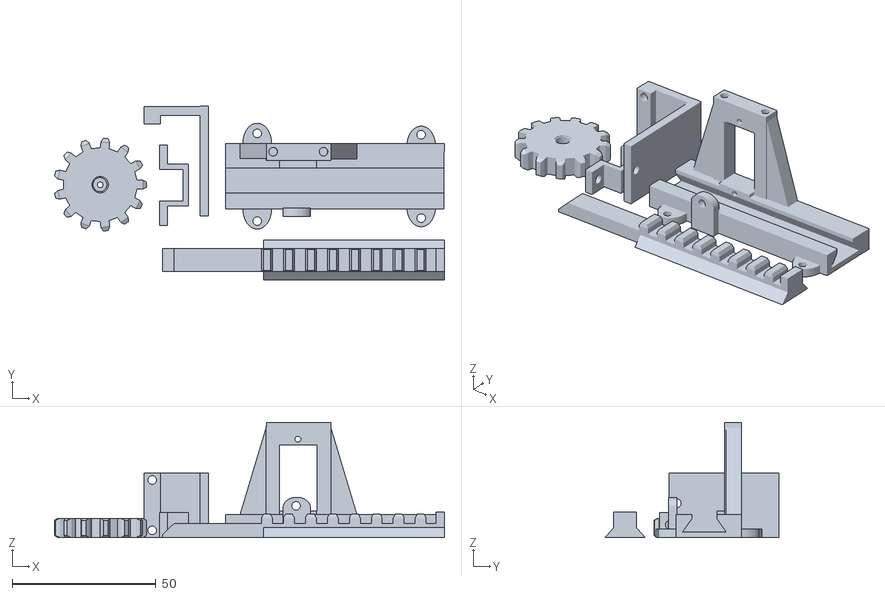
[picture p41: CAD file, 2017-12-07]
ECE477-SeniorDesignProject/Mechanical/linear-servo.stl
135.6 x 60.5 x 40.0
