KaiPeng21/VirtualSport/ECE477-SeniorDesignProject/Mechanical/package-grp2.stl

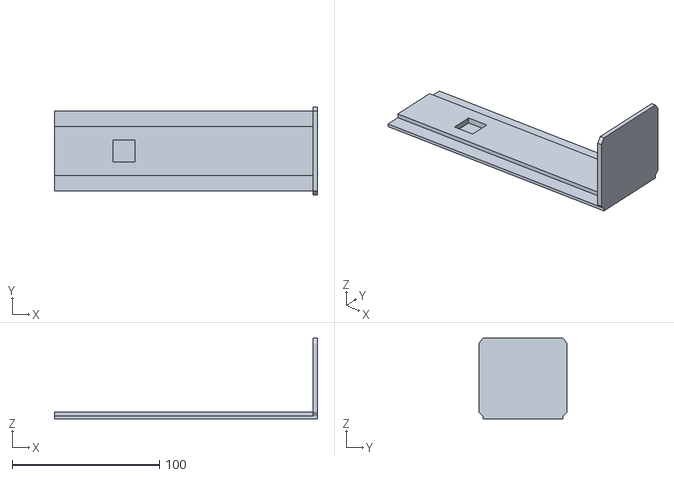
[picture p42: CAD file, 2017-12-07]
ECE477-SeniorDesignProject/Mechanical/package-grp2.stl
178.6 x 60.0 x 55.0
