KaiPeng21/VirtualSport/ECE477-SeniorDesignProject/Mechanical/package-grp4.stl

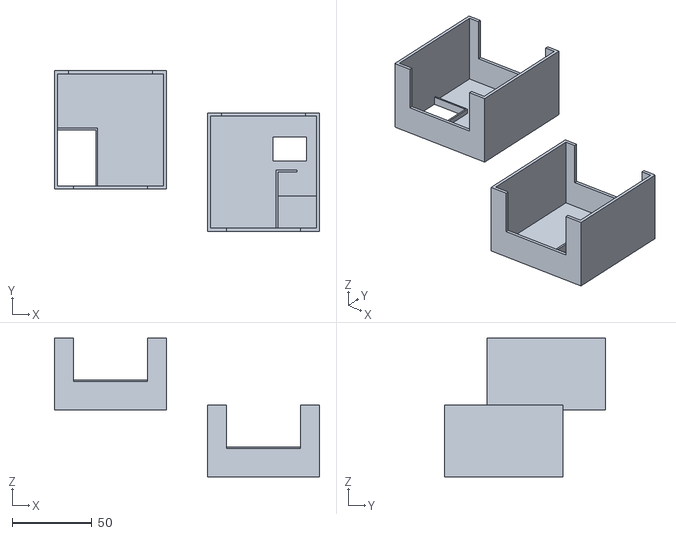
[picture p43: CAD file, 2017-12-07]
ECE477-SeniorDesignProject/Mechanical/package-grp4.stl
165.7 x 100.4 x 86.7
