KaiPeng21/VirtualSport/ECE477-SeniorDesignProject/Hardware/PCB-main/overall_pcb_1_1.pdf

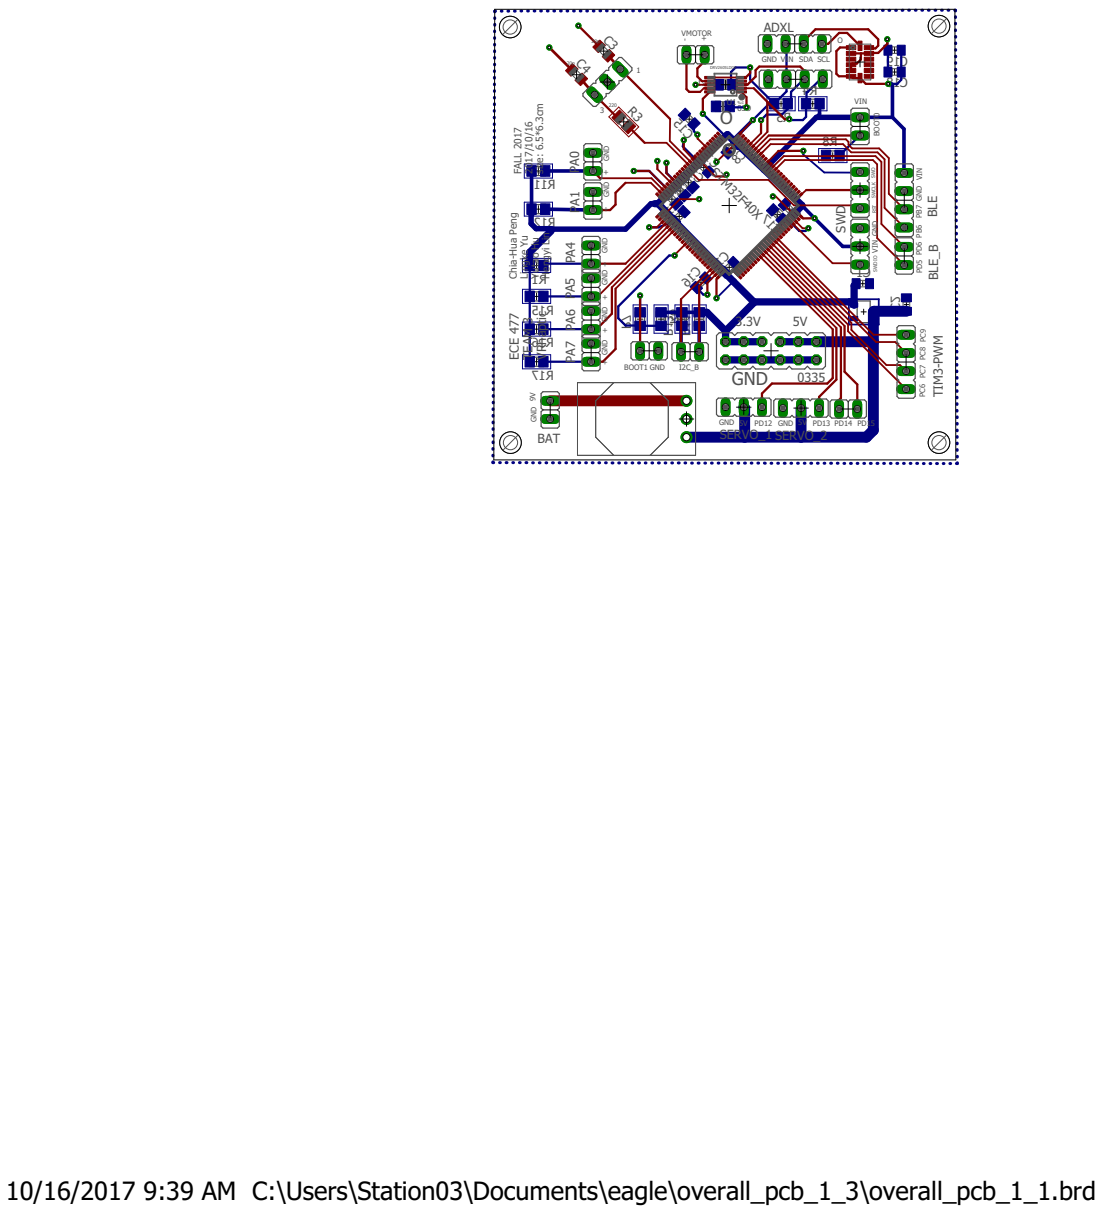
[picture p48: page 1]

GND VIN SDA SCL

GND GND GND GND GND GND + + + + + +

VIN GND RST SWDIO

Lingke Yu Yutao Hu Hengyi Lin

10/16/2017 9:39 AM C:\Users\Station03\Documents\eagle\overall_pcb_1_3\overall_pcb_1_1.brd
