KaiPeng21/VirtualSport/ECE477-SeniorDesignProject/Hardware/PCB-adxl345-breakout/pcb_4.brd

## EAGLE design ECE477-SeniorDesignProject/Hardware/PCB-adxl345-breakout/pcb_4.brd (2017-12-07)

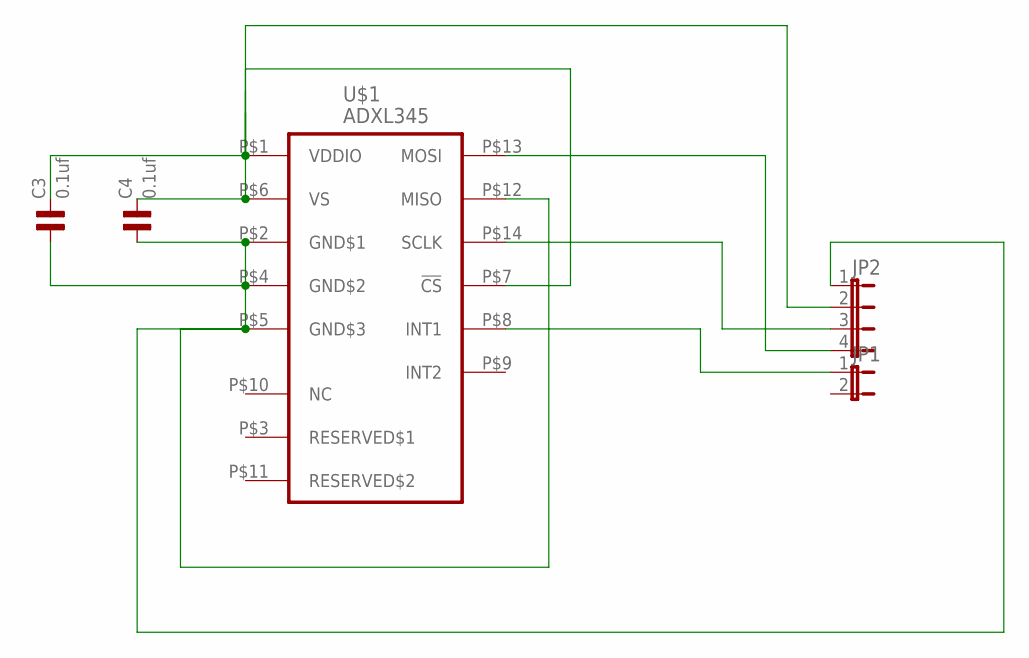
[picture p49: schematic pcb_4.sch]

Parts:
C3, C4: 0.1uf; 0805
JP1: JP1E; JP1
JP2: JP4E; JP4
U$1: ADXL345; LGA14

Connections:
unnamed: C3.1, C4.1, JP2.1, U$1.P$2 (GND$1), U$1.P$4 (GND$2), U$1.P$5 (GND$3), U$1.P$12 (MISO)
unnamed: C3.2, C4.2, JP2.2, U$1.P$1 (VDDIO), U$1.P$6 (VS), U$1.P$7 (!CS)
unnamed: JP2.4, U$1.P$13 (MOSI)
unnamed: JP2.3, U$1.P$14 (SCLK)
unnamed: JP1.1, U$1.P$8 (INT1)

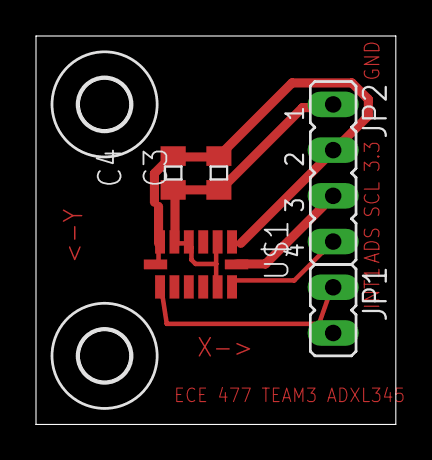
[picture p50: board pcb_4.brd from above]

Board: 2 copper layers, 20.0 x 21.6 mm, 7 parts (0 on the bottom side), 5 nets.

Other parts of the board:
U$2, U$3: 2,8
