KaiPeng21/VirtualSport/ECE477-SeniorDesignProject/Hardware/PCB-main/overall_pcb_1_1.brd

## EAGLE design ECE477-SeniorDesignProject/Hardware/PCB-main/overall_pcb_1_1.brd (2017-12-07)

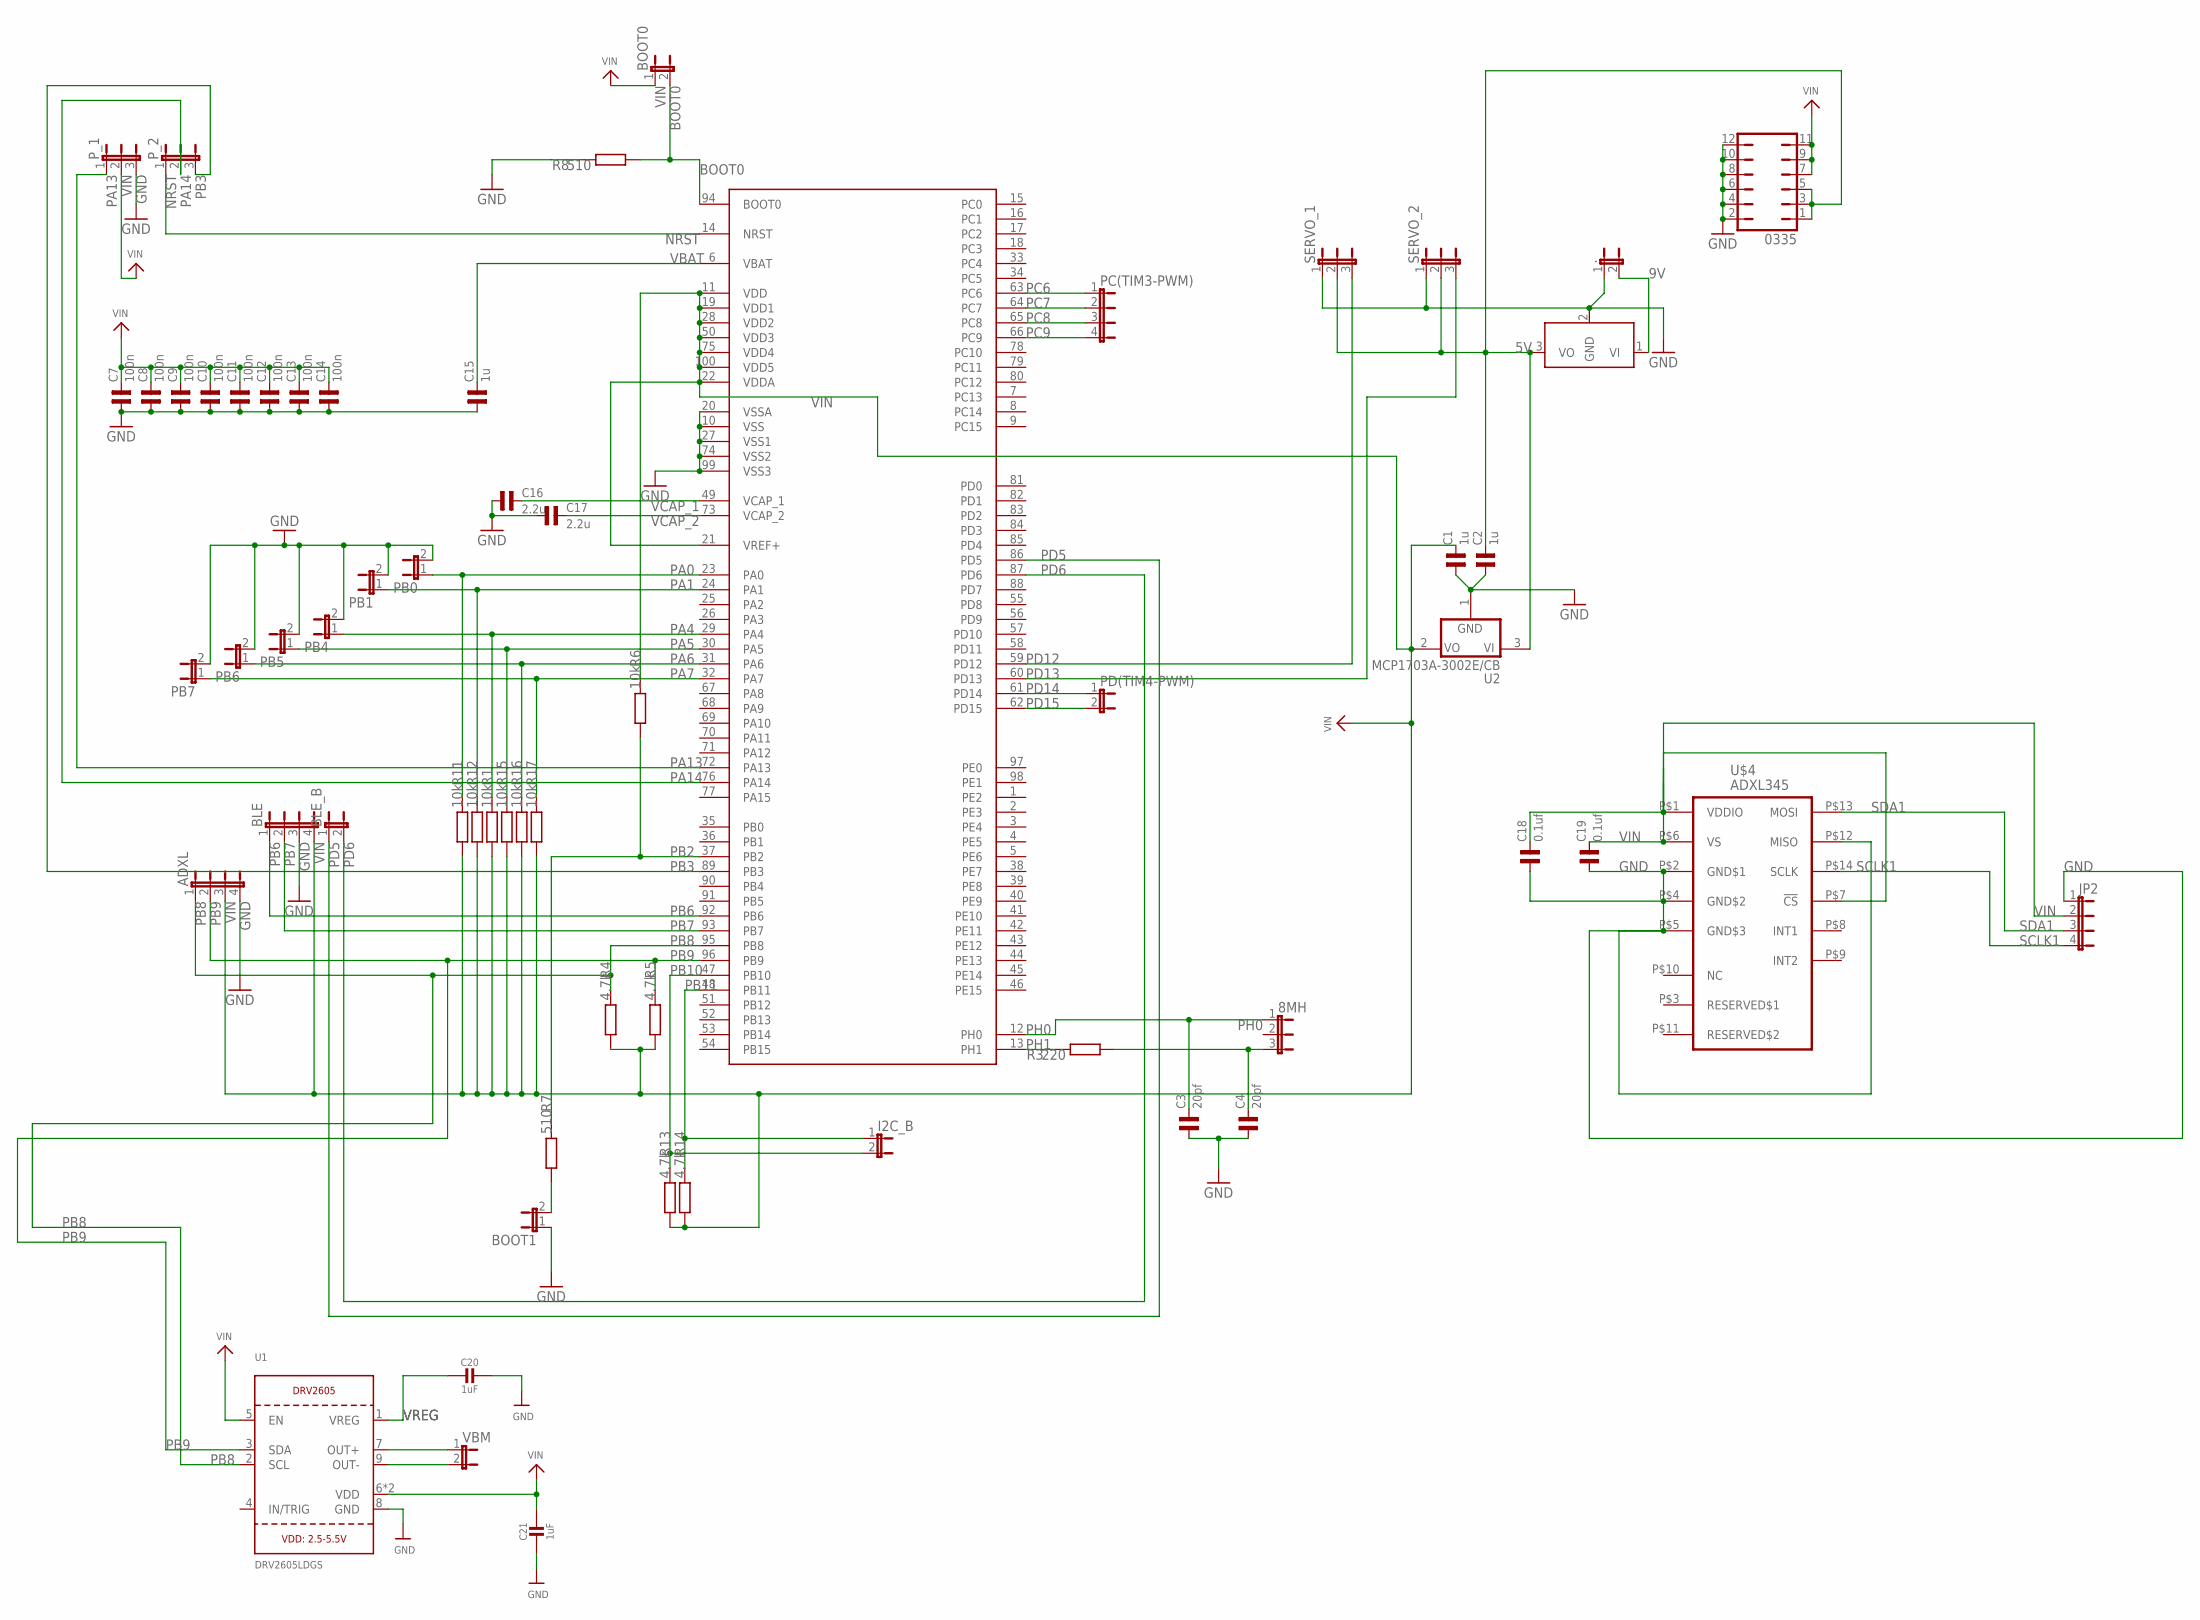
[picture p51: schematic overall_pcb_1_1.sch]

Parts:
8MH: JP2E; JP2
0335: JP6Q
.: JP1E; JP1
ADXL: JP4E; JP4
BLE: JP4E; JP4
BLE_B: JP1E; JP1
BOOT0, BOOT1: JP1E; JP1
C1, C2, C15: 1u; 0805
C3, C4: 20pf; 0805
C7, C8, C9, C10, C11, C12, C13, C14: 100n; 0805
C16, C17: 2.2u; 0805
C18, C19: 0.1uf; 0805
C20, C21: 1uF; 0805-NO
I2C_B: JP1E; JP1
JP2: JP4E; JP4
PB0, PB1, PB4, PB5, PB6, PB7: JP1E; JP1
PC(TIM3-PWM): JP4E; JP4
PD(TIM4-PWM): JP1E; JP1
P_1, P_2: JP2E; JP2
R1, R6, R11, R12, R15, R16, R17: 10k; R0805
R3: 220; R0805
R4, R5, R13, R14: 4.7k; R0805
R7, R8: 510; R0805
SERVO_1, SERVO_2: JP2E; JP2
U1: DRV2605LDGS; PSOP10
U2: MCP1703A-3002E/CB; SOT23A_MICROCHIP_CB
U$1: STM32F40XSTM32D40X; LQFP100
U$2: DCDC_OKI-78SR; OKI-78SRH
U$4: ADXL345; LGA14
VBM: JP1E; JP1

Connections:
5V: 0335.1, 0335.3, 0335.5, C2.2, SERVO_1.2, SERVO_2.2, U2.3 (VI), U$2.3 (VO)
9V: ..2, U$2.1 (VI)
BOOT0: BOOT0.2, R8.1, U$1.94 (BOOT0)
GND: 0335.2, 0335.4, 0335.6, 0335.8, 0335.10, 0335.12, ..1, ADXL.4, BLE.3, BOOT1.1, C1.1, C2.1, C3.1, C4.1, C7.1, C8.1, C9.1, C10.1, C11.1, C12.1, C13.1, C14.1, C15.1, C16.1, C17.1, C18.1, C19.1, C20.1, C21.2, JP2.1, PB0.2, PB1.2, PB4.2, PB5.2, PB6.2, PB7.2, P_1.3, R8.2, SERVO_1.1, SERVO_2.1, U1.8 (GND), U2.1 (GND), U$1.10 (VSS), U$1.20 (VSSA), U$1.27 (VSS1), U$1.74 (VSS2), U$1.99 (VSS3), U$2.2 (GND), U$4.P$2 (GND$1), U$4.P$4 (GND$2), U$4.P$5 (GND$3), U$4.P$12 (MISO)
unnamed: BOOT1.2, R7.1
unnamed: 8MH.3, C4.2, R3.1
NRST: P_2.1, U$1.14 (NRST)
OUT+: U1.7 (OUT+), VBM.1
OUT-: U1.9 (OUT-), VBM.2
PA0: PB0.1, R11.2, U$1.23 (PA0)
PA1: PB1.1, R12.2, U$1.24 (PA1)
PA4: PB4.1, R1.2, U$1.29 (PA4)
PA5: PB5.1, R15.2, U$1.30 (PA5)
PA6: PB6.1, R16.2, U$1.31 (PA6)
PA7: PB7.1, R17.2, U$1.32 (PA7)
PA13: P_1.1, U$1.72 (PA13)
PA14: P_2.2, U$1.76 (PA14)
PB2: R6.1, R7.2, U$1.37 (PB2)
PB3: P_2.3, U$1.89 (PB3)
PB6: BLE.1, U$1.92 (PB6)
PB7: BLE.2, U$1.93 (PB7)
PB8: ADXL.1, R4.2, U1.2 (SCL), U$1.95 (PB8)
PB9: ADXL.2, R5.2, U1.3 (SDA), U$1.96 (PB9)
PB10: I2C_B.2, R13.2, U$1.47 (PB10)
PB11: I2C_B.1, R14.2, U$1.48 (PB11)
PC6: PC(TIM3-PWM).1, U$1.63 (PC6)
PC7: PC(TIM3-PWM).2, U$1.64 (PC7)
PC8: PC(TIM3-PWM).3, U$1.65 (PC8)
PC9: PC(TIM3-PWM).4, U$1.66 (PC9)
PD5: BLE_B.1, U$1.86 (PD5)
PD6: BLE_B.2, U$1.87 (PD6)
PD12: SERVO_1.3, U$1.59 (PD12)
PD13: SERVO_2.3, U$1.60 (PD13)
PD14: PD(TIM4-PWM).1, U$1.61 (PD14)
PD15: PD(TIM4-PWM).2, U$1.62 (PD15)
PH0: 8MH.1, C3.2, U$1.12 (PH0)
PH1: R3.2, U$1.13 (PH1)
SCLK1: JP2.4, U$4.P$14 (SCLK)
SDA1: JP2.3, U$4.P$13 (MOSI)
VBAT: C15.2, U$1.6 (VBAT)
VCAP_1: C16.2, U$1.49 (VCAP_1)
VCAP_2: C17.2, U$1.73 (VCAP_2)
VIN: 0335.7, 0335.9, 0335.11, ADXL.3, BLE.4, BOOT0.1, C1.2, C7.2, C8.2, C9.2, C10.2, C11.2, C12.2, C13.2, C14.2, C18.2, C19.2, C21.1, JP2.2, P_1.2, R1.1, R4.1, R5.1, R6.2, R11.1, R12.1, R13.1, R14.1, R15.1, R16.1, R17.1, U1.5 (EN), U1.6 (VDD), U1.10 (VDD), U2.2 (VO), U$1.11 (VDD), U$1.19 (VDD1), U$1.21 (VREF+), U$1.22 (VDDA), U$1.28 (VDD2), U$1.50 (VDD3), U$1.75 (VDD4), U$1.100 (VDD5), U$4.P$1 (VDDIO), U$4.P$6 (VS), U$4.P$7 (!CS)
VREG: C20.2, U1.1 (VREG)

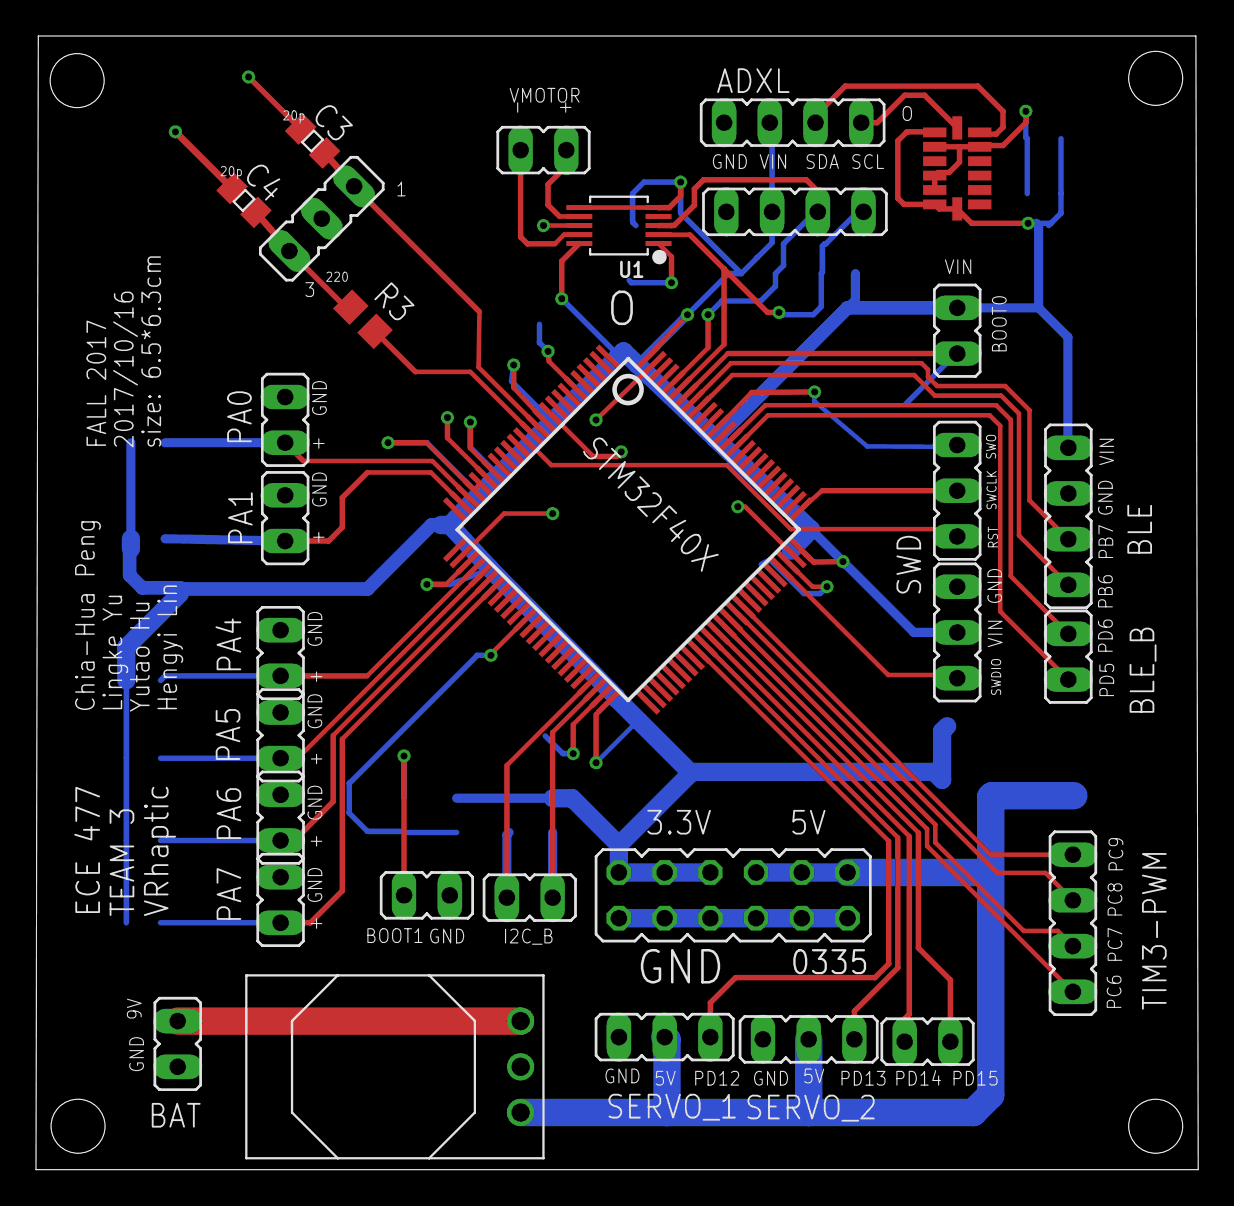
[picture p52: board overall_pcb_1_1.brd from above]

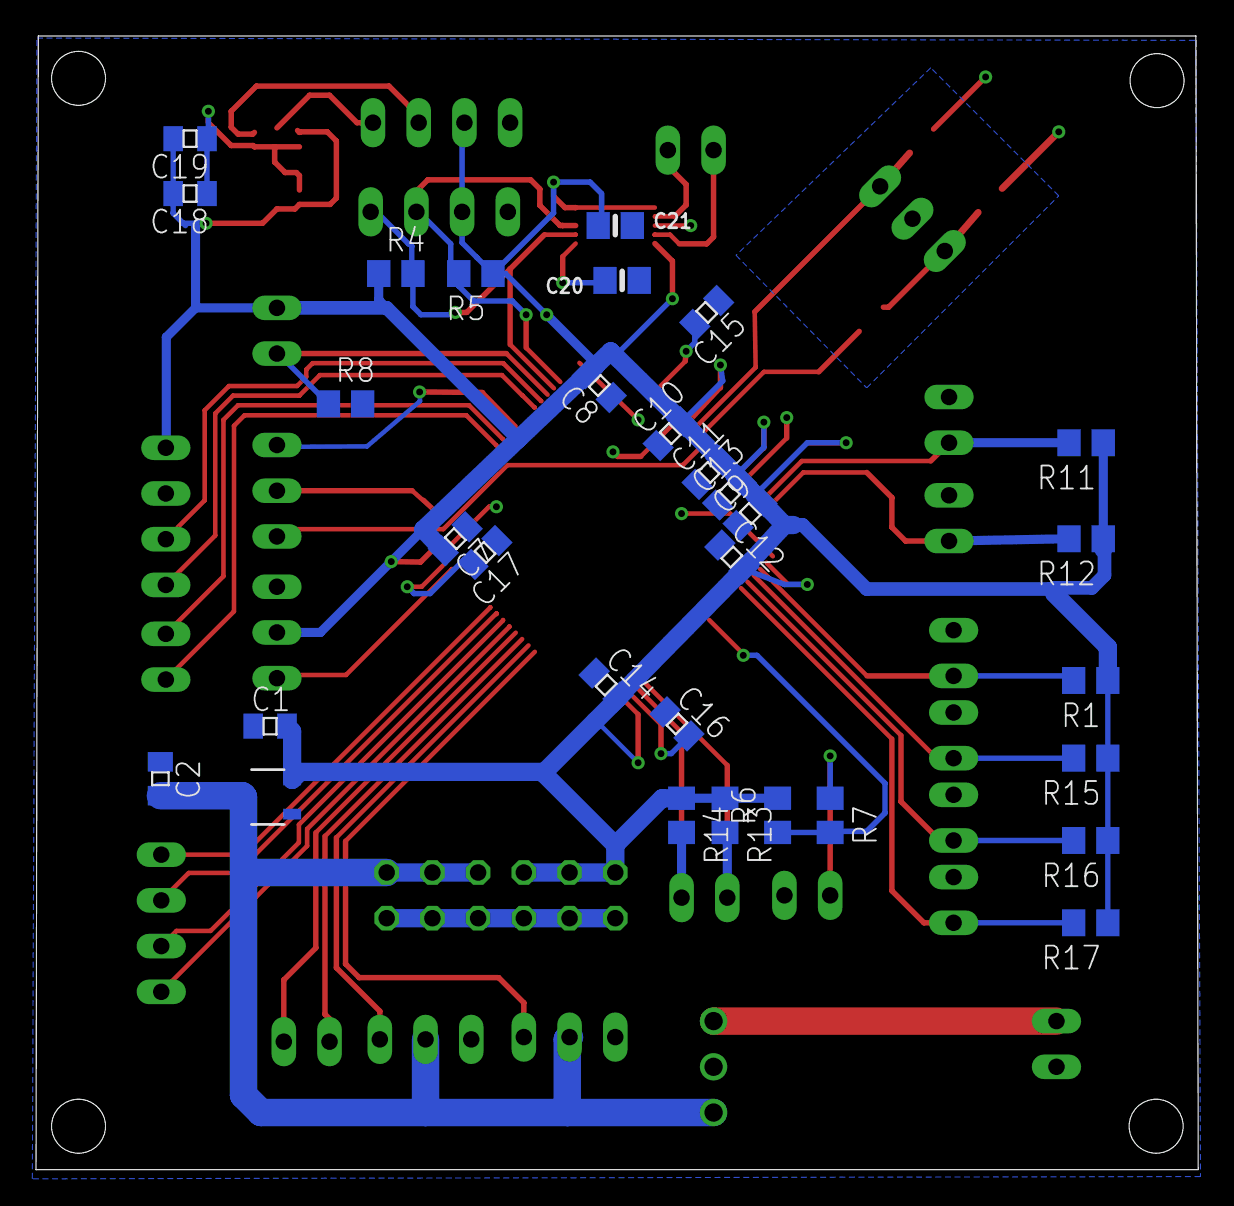
[picture p53: board overall_pcb_1_1.brd from below]

Board: 2 copper layers, 64.6 x 63.0 mm, 61 parts (31 on the bottom side), 44 nets.
