KaiPeng21/VirtualSport/ECE477-SeniorDesignProject/Software/Microprocessor/Final-Version-1.ioc

Mcu.UserName=STM32F407VGTx
PA0-WKUP.Signal=GPIO_Input
PA1.Signal=GPIO_Input
PA13.Signal=SYS_JTMS-SWDIO
PA14.Signal=SYS_JTCK-SWCLK
PA4.Signal=GPIO_Input
PA5.Signal=GPIO_Input
PA6.Signal=GPIO_Input
PA7.Signal=GPIO_Input
PB10.Signal=I2C2_SCL
PB11.Signal=I2C2_SDA
PB3.Signal=SYS_JTDO-SWO
PB6.Signal=USART1_TX
PB7.Signal=USART1_RX
PB8.Signal=I2C1_SCL
PB9.Signal=I2C1_SDA
PC6.Signal=S_TIM3_CH1
PC7.Signal=S_TIM3_CH2
PC8.Signal=S_TIM3_CH3
PC9.Signal=S_TIM3_CH4
PD12.Signal=S_TIM4_CH1
PD13.Signal=S_TIM4_CH2
PD14.Signal=S_TIM4_CH3
PD15.Signal=S_TIM4_CH4
PD5.Signal=USART2_TX
PD6.Signal=USART2_RX
PH0-OSC_IN.Signal=RCC_OSC_IN
PH1-OSC_OUT.Signal=RCC_OSC_OUT
