KaiPeng21/VirtualSport/(commit log)

2017-12-07 documents added
    [team03-05-BillOfMaterial.xlsx]
2017-12-07 Mechanical added
    [linear-servo.stl, package-grp1.stl, package-grp2.stl, package-grp3.stl, package-grp4.stl]
2017-12-07 Hardware added
    [overall_pcb_1_1.brd, overall_pcb_1_1.sch, pcb_4.brd, pcb_4.sch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]
